grahamsider/photonic-harp/README.md

# iHarp (A Photonic Harp implemented in Verilog)

## Block Diagram
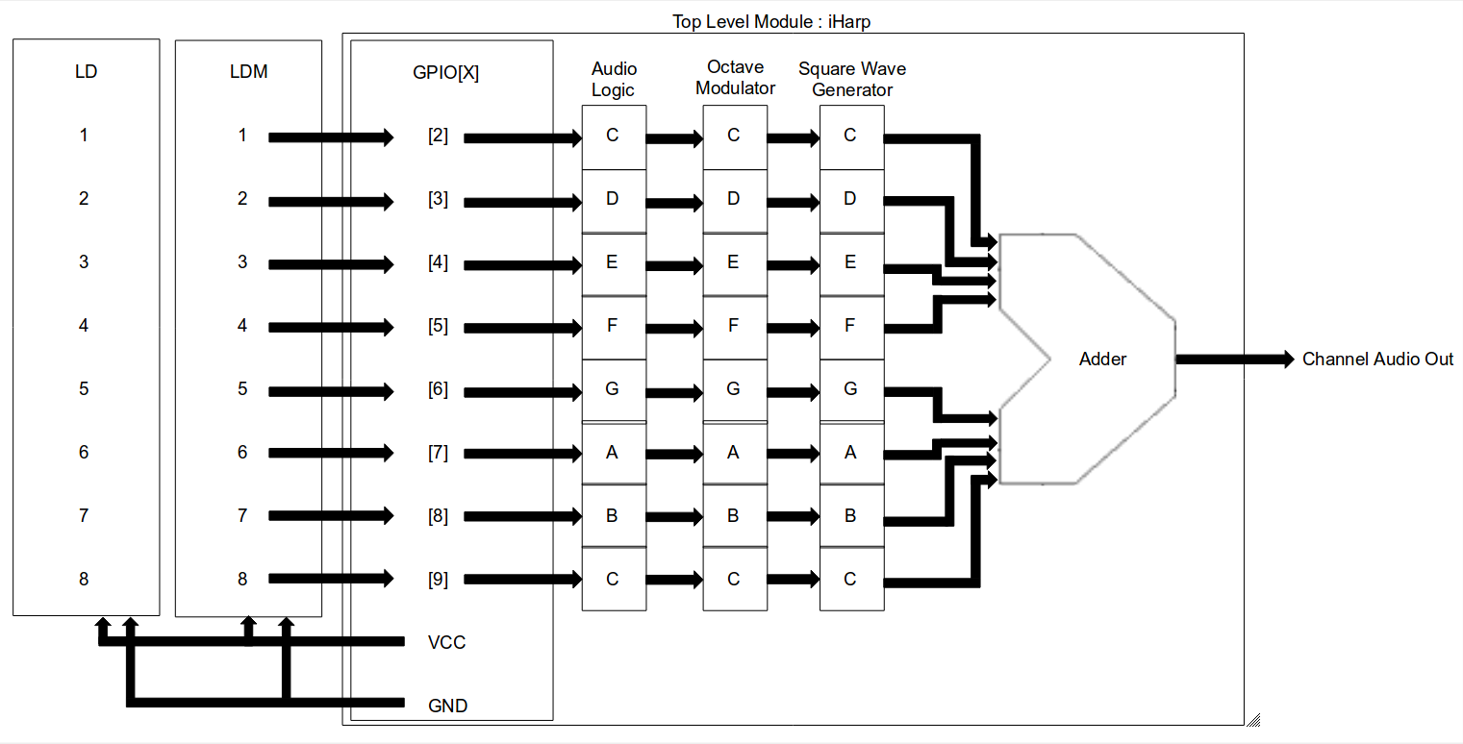
[picture p1: Final Report/ECE241 Final Report Block Diagram.png]
Block Diagram


See the "Final Report" directory for more details.

Project was created by ECE 2T0s Graham Sider and Michael Hong at the University of Toronto as the final project of ECE241 (Digital Systems).
