grahamsider/photonic-harp/Final Report/ECE241 Final Report Appendix.pdf

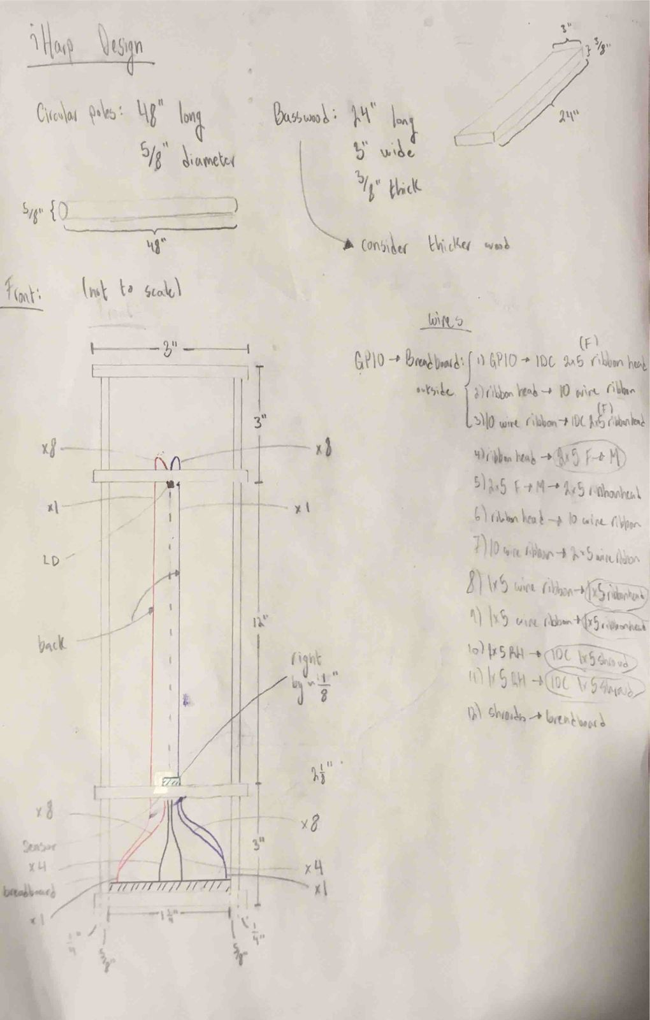
[picture p2: page 1]

Appendix
Figure 1: Original Proposed Design (p1/2)

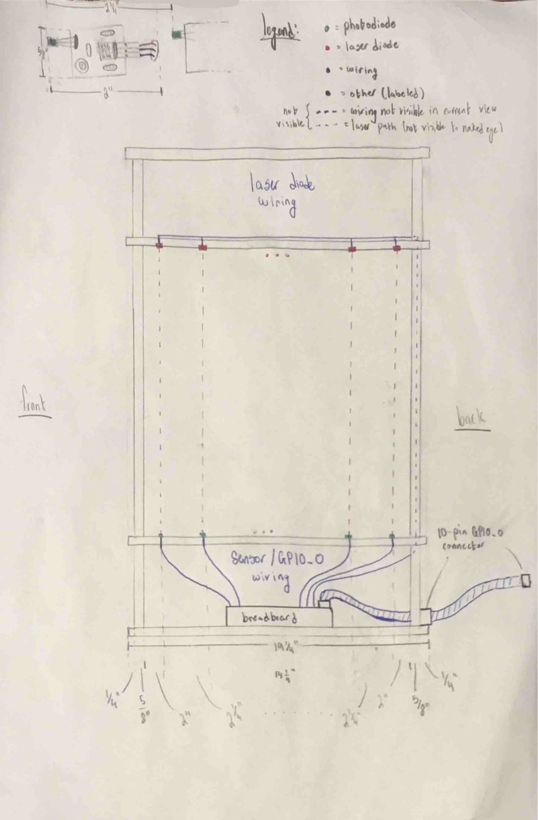
[picture p3: page 2]

Figure 2: Original Proposed Design (p2/2)

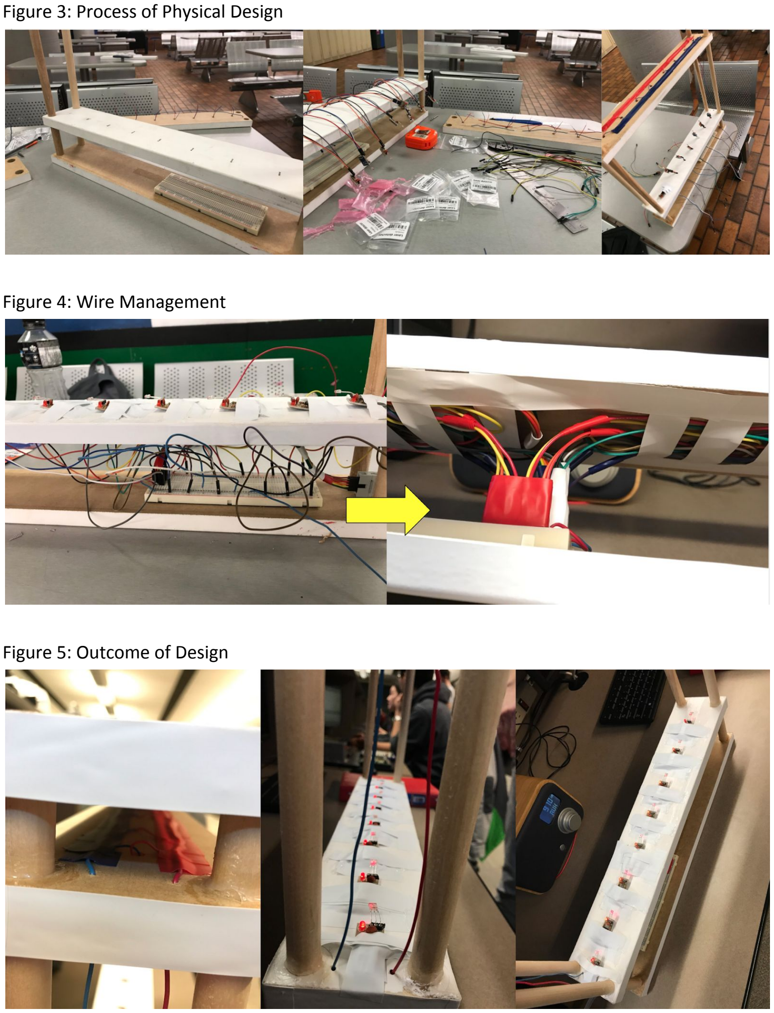
[picture p4: page 3]

Figure 3: Process of Physical Design

Figure 4: Wire Management

Figure 5: Outcome of Design

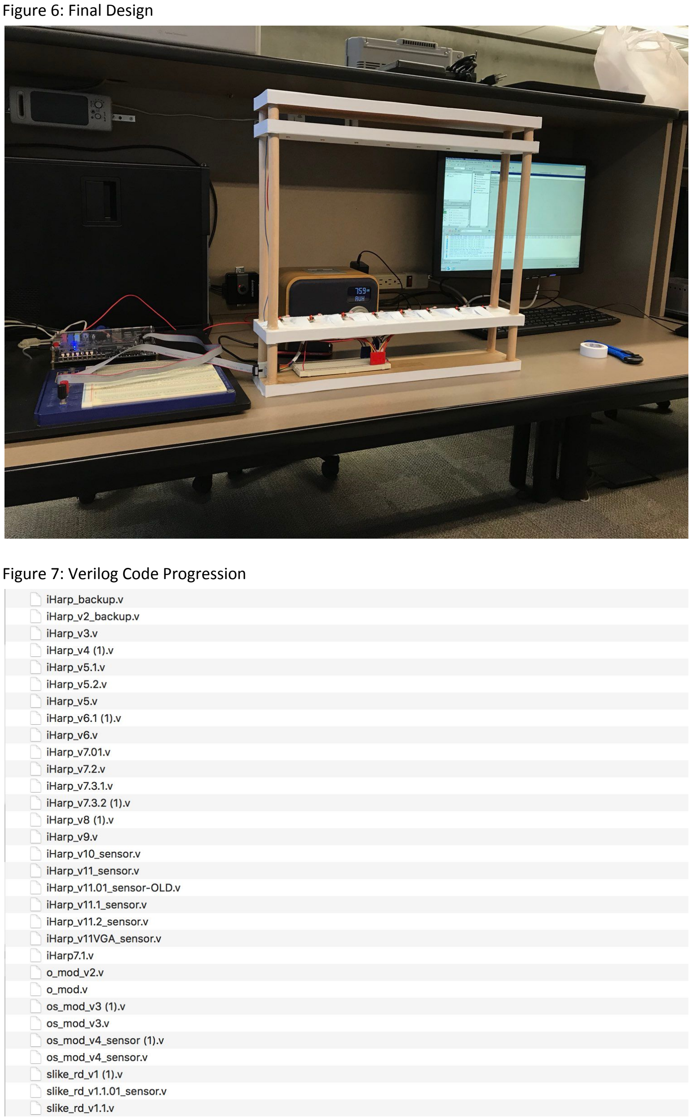
[picture p5: page 4]

Figure 6: Final Design

Figure 7: Verilog Code Progression

Materials Purchased/Used:

- 8x Red Laser Pointer (5V)
- 8x Laser Detector Module
- Breadboard
- Various Ribbon Connectors
- Various Pin Connectors
- Wires
- Building Materials (i.e. wood, tape, epoxy, etc.)
